dhebbeker/robot-control/robot-control-src/src/device_drivers/README.md

\dir .
\brief device drivers

This directory contains device drivers.
The drivers are not specific for a certain application or hardware.
They each support a specific device which may be configured.
