dhebbeker/robot-control/doc/follow-wall-angle/WinkelberechnungV4-2.pdf

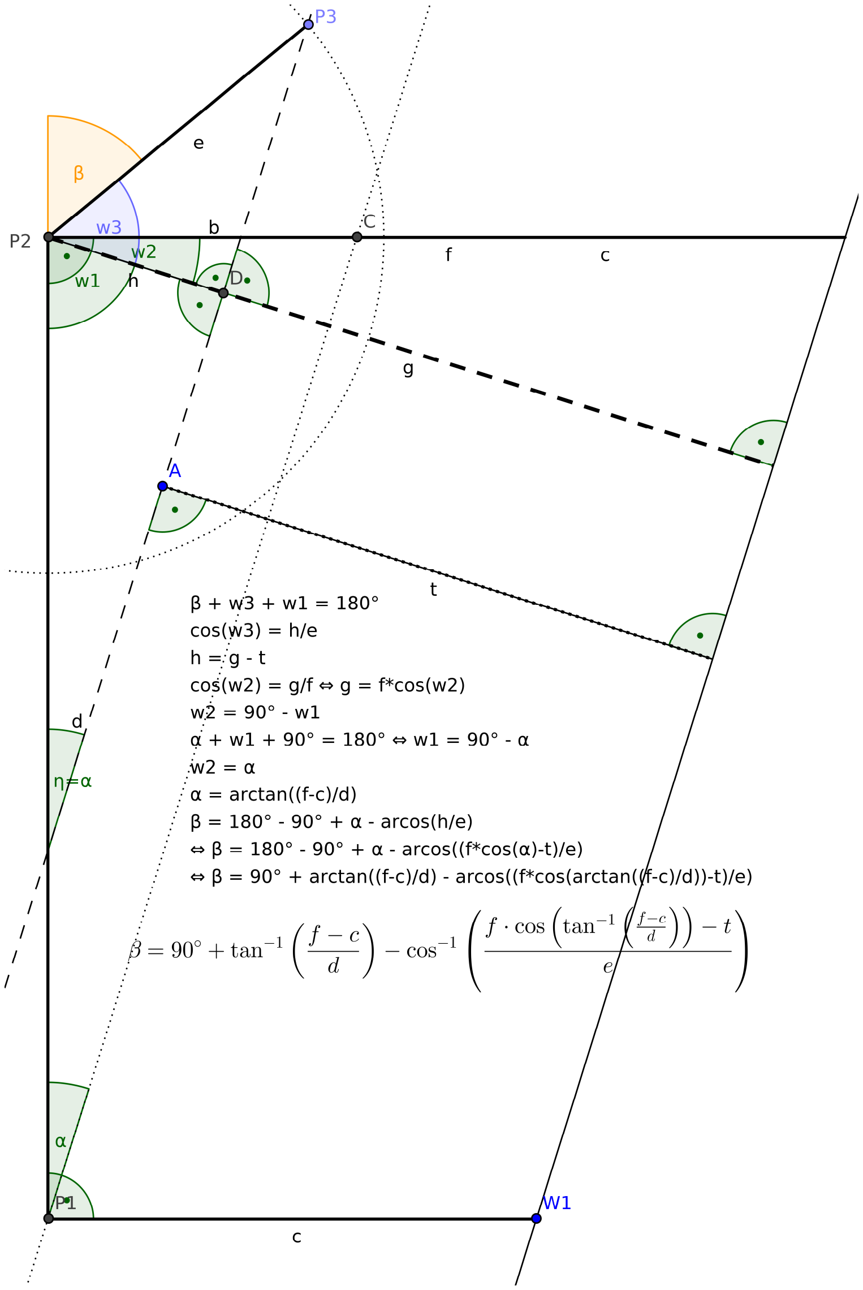
[picture p3: page 1]
