dhebbeker/robot-control/doc/follow-wall-angle/WinkelberechnungV4.pdf

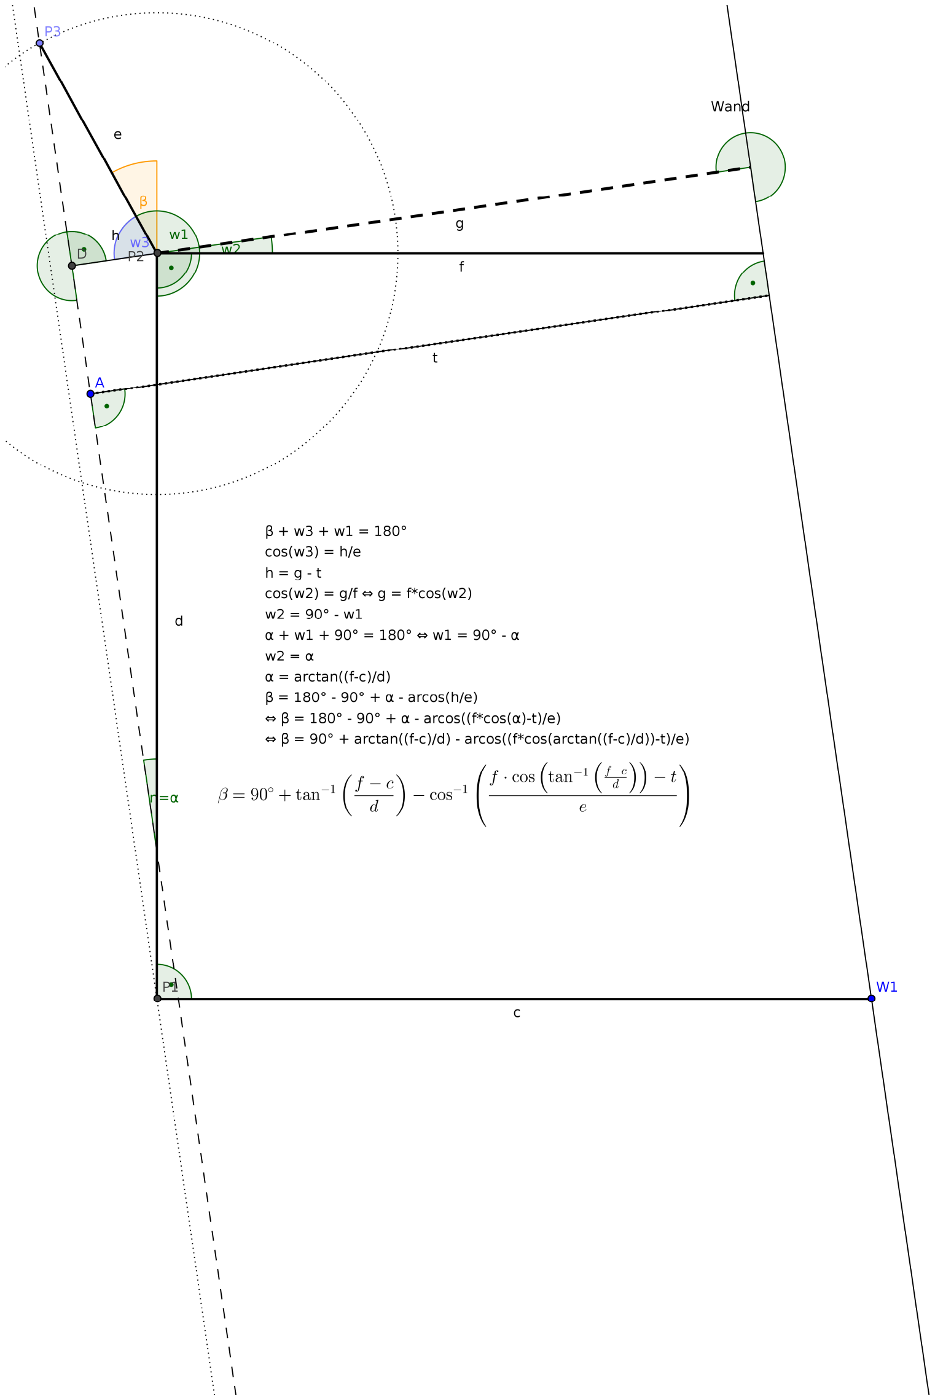
[picture p4: page 1]
