dhebbeker/robot-control/hardware/robot-control-circuit/robot-control-circuit.kicad_pcb

## KiCad design hardware/robot-control-circuit/robot-control-circuit.kicad_pcb (2021-12-05)

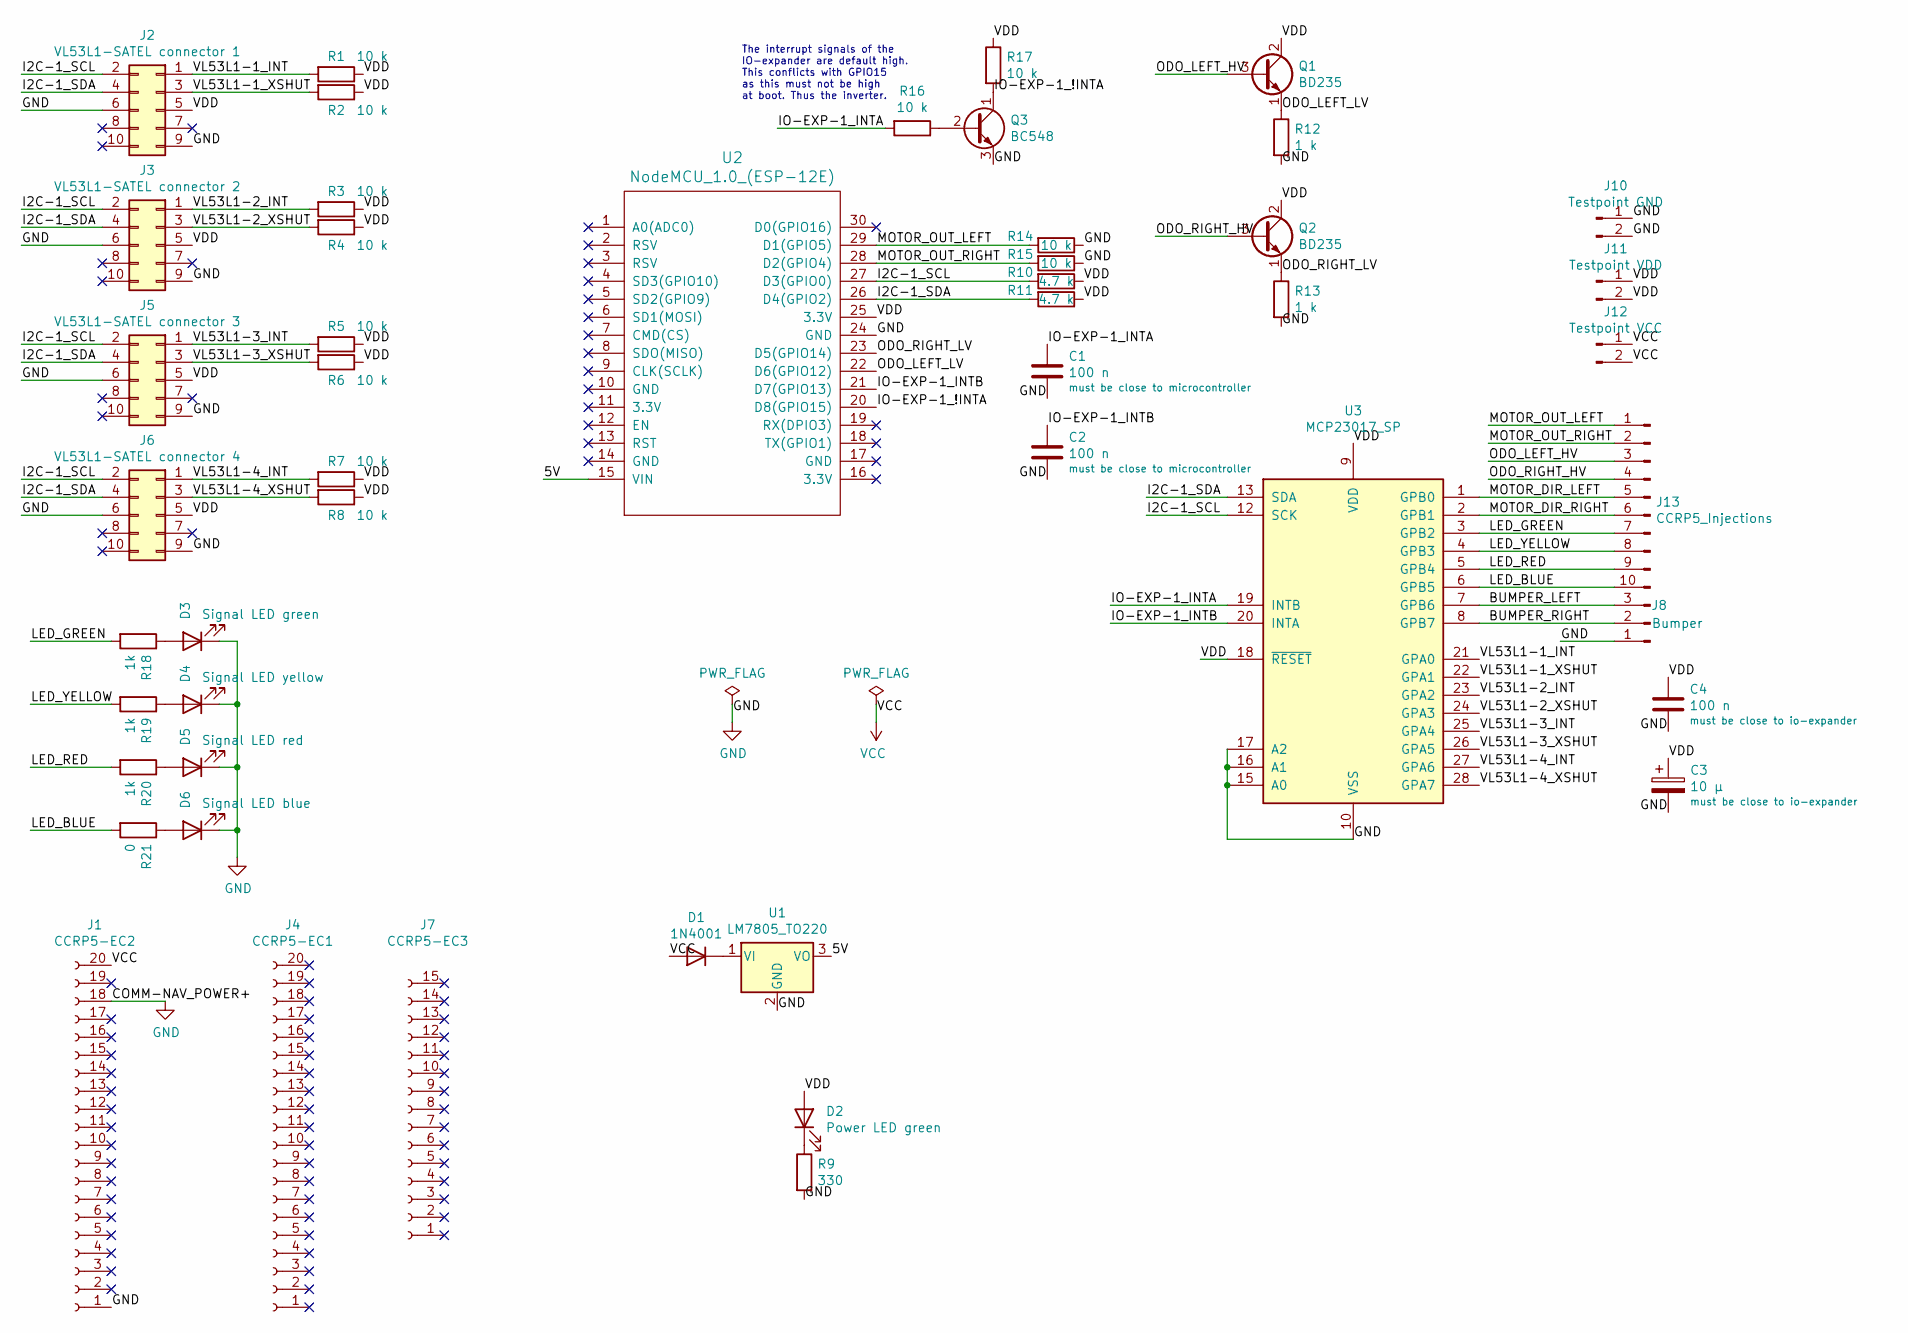
[picture p5: schematic robot-control-circuit.sch, Navigation Board]

Parts:
C1, C2, C4: 100 n; C_Rect_L4.6mm_W2.0mm_P2.50mm_MKS02_FKP02
C3: 10 µ; CP_Radial_D5.0mm_P2.50mm
D1: 1N4001; D_DO-34_SOD68_P2.54mm_Vertical_KathodeUp
D2: Power LED green; LED_D3.0mm
D3: Signal LED green; LED_D3.0mm
D4: Signal LED yellow; LED_D3.0mm
D5: Signal LED red; LED_D3.0mm
D6: Signal LED blue; LED_D3.0mm
J1: CCRP5-EC2; PinHeader_1x20_P2.54mm_Vertical; Part SSA-120-W-T
J2: VL53L1-SATEL connector 1; PinSocket_2x05_P2.54mm_Horizontal
J3: VL53L1-SATEL connector 2; PinSocket_2x05_P2.54mm_Horizontal
J4: CCRP5-EC1; PinHeader_1x20_P2.54mm_Vertical; Part SSA-120-W-T
J5: VL53L1-SATEL connector 3; PinSocket_2x05_P2.54mm_Horizontal
J6: VL53L1-SATEL connector 4; PinSocket_2x05_P2.54mm_Horizontal
J7: CCRP5-EC3; PinHeader_1x15_P2.54mm_Vertical
J8: Bumper; PinHeader_1x03_P2.54mm_Vertical
J10: Testpoint GND; PinHeader_1x02_P2.54mm_Vertical
J11: Testpoint VDD; PinHeader_1x02_P2.54mm_Vertical
J12: Testpoint VCC; PinHeader_1x02_P2.54mm_Vertical
J13: CCRP5_Injections; PinHeader_1x10_P2.54mm_Vertical
Q1, Q2: BD235; TO-126-3_Vertical
Q3: BC548; TO-92_Inline_Wide
R1, R2, R3, R4, R5, R6, R7, R8, R14, R15, R16, R17: 10 k; R_Axial_DIN0204_L3.6mm_D1.6mm_P2.54mm_Vertical
R9: 330; R_Axial_DIN0204_L3.6mm_D1.6mm_P2.54mm_Vertical
R10, R11: 4.7 k; R_Axial_DIN0204_L3.6mm_D1.6mm_P2.54mm_Vertical
R12, R13: 1 k; R_Axial_DIN0204_L3.6mm_D1.6mm_P2.54mm_Vertical
R18, R19, R20: 1k; R_Axial_DIN0204_L3.6mm_D1.6mm_P2.54mm_Vertical
R21: 0; R_Axial_DIN0204_L3.6mm_D1.6mm_P2.54mm_Vertical
U1: LM7805_TO220; TO-220-3_Vertical
U2: NodeMCU_1.0_(ESP-12E); NodeMCU1.0(12-E)
U3: MCP23017_SP; DIP-28_W7.62mm

Connections:
/5V: U1.3 (VO), U2.15 (VIN)
/BUMPER_LEFT: J8.3, U3.7 (GPB6)
/BUMPER_RIGHT: J8.2, U3.8 (GPB7)
/I2C-1_SCL: J2.2, J3.2, J5.2, J6.2, R10.2, U2.27 (D3(GPIO0)), U3.12 (SCK)
/I2C-1_SDA: J2.4, J3.4, J5.4, J6.4, R11.2, U2.26 (D4(GPIO2)), U3.13 (SDA)
/IO-EXP-1_!INTA: Q3.1 (C), R17.2, U2.20 (D8(GPIO15))
/IO-EXP-1_INTA: C1.1, R16.2, U3.19 (INTB)
/IO-EXP-1_INTB: C2.1, U2.21 (D7(GPIO13)), U3.20 (INTA)
/LED_BLUE: J13.10, R21.2, U3.6 (GPB5)
/LED_GREEN: J13.7, R18.2, U3.3 (GPB2)
/LED_RED: J13.9, R20.2, U3.5 (GPB4)
/LED_YELLOW: J13.8, R19.2, U3.4 (GPB3)
/MOTOR_DIR_LEFT: J13.5, U3.1 (GPB0)
/MOTOR_DIR_RIGHT: J13.6, U3.2 (GPB1)
/MOTOR_OUT_LEFT: J13.1, R14.2, U2.29 (D1(GPIO5))
/MOTOR_OUT_RIGHT: J13.2, R15.2, U2.28 (D2(GPIO4))
/ODO_LEFT_HV: J13.3, Q1.3 (B)
/ODO_LEFT_LV: Q1.1 (E), R12.1, U2.22 (D6(GPIO12))
/ODO_RIGHT_HV: J13.4, Q2.3 (B)
/ODO_RIGHT_LV: Q2.1 (E), R13.1, U2.23 (D5(GPIO14))
/VDD: C3.1, C4.1, D2.2 (A), J2.5, J3.5, J5.5, J6.5, J11.1, J11.2, Q1.2 (C), Q2.2 (C), R1.1, R2.1, R3.1, R4.1, R5.1, R6.1, R7.1, R8.1, R10.1, R11.1, R17.1, U2.25 (3.3V), U3.9 (VDD), U3.18 (~RESET~)
/VL53L1-1_INT: J2.1, R1.2, U3.21 (GPA0)
/VL53L1-1_XSHUT: J2.3, R2.2, U3.22 (GPA1)
/VL53L1-2_INT: J3.1, R3.2, U3.23 (GPA2)
/VL53L1-2_XSHUT: J3.3, R4.2, U3.24 (GPA3)
/VL53L1-3_INT: J5.1, R5.2, U3.25 (GPA4)
/VL53L1-3_XSHUT: J5.3, R6.2, U3.26 (GPA5)
/VL53L1-4_INT: J6.1, R7.2, U3.27 (GPA6)
/VL53L1-4_XSHUT: J6.3, R8.2, U3.28 (GPA7)
GND: C1.2, C2.2, C3.2, C4.2, D3.1 (K), D4.1 (K), D5.1 (K), D6.1 (K), J1.1, J1.18, J2.6, J2.9, J3.6, J3.9, J5.6, J5.9, J6.6, J6.9, J8.1, J10.1, J10.2, Q3.3 (E), R9.2, R12.2, R13.2, R14.1, R15.1, U1.2 (GND), U2.24 (GND), U3.10 (VSS), U3.15 (A0), U3.16 (A1), U3.17 (A2)
unnamed: D1.1 (K), U1.1 (VI)
unnamed: D2.1 (K), R9.1
unnamed: D3.2 (A), R18.1
unnamed: D4.2 (A), R19.1
unnamed: D5.2 (A), R20.1
unnamed: D6.2 (A), R21.1
unnamed: Q3.2 (B), R16.1
VCC: D1.2 (A), J1.20, J12.1, J12.2

Notes on the sheet:
The interrupt signals of the IO-expander are default high. This conflicts with GPIO15 as this must not be high at boot. Thus the inverter.

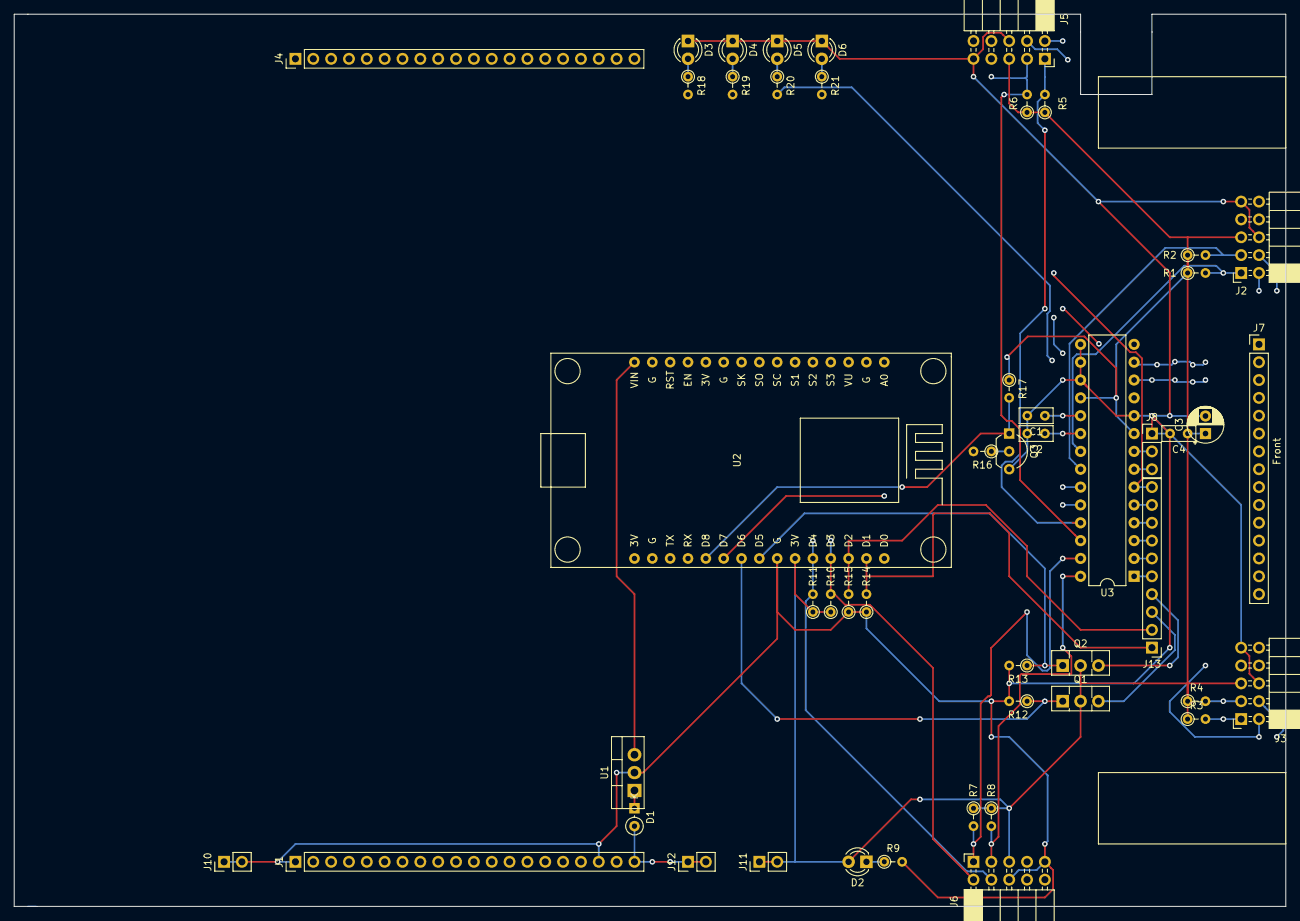
[picture p6: board robot-control-circuit.kicad_pcb from above]

Board: 4 copper layers, 181.0 x 127.0 mm, 49 parts (0 on the bottom side), 38 nets.
