dhebbeker/robot-control/(commit log)

2021-01-17 Add current work in progress.
    I have been working on this project for a couple of days since 2021-01-07.
2021-01-17 Added source code and documentation used to calibrate drives.
2021-04-25 Define circuit and PCB.
    Includes
    - 1 NodeMCU
    - 4 VL53C1CB breakout boards
    - 1 MCP23017 IO expander
    - 2 front bumper
    [robot-control-circuit.kicad_pcb, robot-control-circuit.sch]
2021-04-25 Add workaround for bug in external board package.
    See https://github.com/esp8266/Arduino/issues/5787#issuecomment-465852231
    Beware: The #undef directive must be issued after `#include <Arduino.h>` and before including any file that defines `std::round`.
    [Drives.hpp, board.hpp]
2021-05-01 Added inverter between D0 and !RESET of IO expander.
    As in case the IO expander is active during boot, it puts INTB high, which is connected to GPIO15 which shall not be high during boot. Else boot fails.
    [robot-control-circuit.kicad_pcb, robot-control-circuit.sch]
2021-05-02 Added capacitors for io-expander.
    [robot-control-circuit.kicad_pcb, robot-control-circuit.sch]
2021-05-02 Directly connect !RESET of IO-expander to VDD and invert INTA.
    [robot-control-circuit.kicad_pcb, robot-control-circuit.sch]
2021-05-04 Corrected left right bumper signal labels.
    [robot-control-circuit.sch]
2021-05-04 Add interface for GPIO and pin implementation.
2021-05-04 Change interface for virtual pin to integers.
    In order to be compatible with Arduino.
2021-05-04 Added function to attach interrupts to digital pin.
    Tested successfully!
2021-05-04 Add PWM function to DigitalPin.
2021-05-05 Added class for virtual pin on IO expander MCP23017.
2021-05-05 Add initialization of I2C for dedicated pins.
2021-05-05 Set correct I2C address for IO expander.
    [board.cpp]
2021-05-05 Initialize remaining board pins.
2021-05-06 Back to static Drive class template.
    Simplified ISR for odometry.
2021-05-09 Added documentation on odometry calculation.
    See https://rn-wissen.de/wiki/index.php/CCRP5#Odometrie
2021-05-09 Added threshold to odometry counter.
    In order to suppress bouncing.
2021-05-09 Attach bumper interrupt to stop condition.
2021-05-11 Fixed backward / forward direction.
    This is because the robot is now operated backwards by default.
    [Drives.cpp, Drives.hpp]
2021-05-11 Added lock to move but backwards in case bumper is pressed.
2021-05-19 Removed connection table from README.
    As that table is redundant to the schematics.
2021-05-19 Use public URI for kicad-ESP8266 submodule.
2021-05-23 Use VL53L1 sensors.
2021-10-10 Moved files to src/ directory for recursive build.
    See https://github.com/arduino/arduino-builder/pull/148
2021-10-10 Update doxygen configuration to version 1.9.3.
    - Automatic update with `doxygen -u`.
    - Added extension mapping for `ino` files (Arduino Sketches)
    - Added path for mainpage
2021-10-23 Added prototype for circular buffer.
2021-10-24 Change sensor report to single range.
2021-10-24 Change sensor report to store sensor distance.
2021-10-24 Add function to steer drives with independent speed.
2021-10-24 Rotate in case no wall is seen.
2021-10-29 Update ESP8266 board support package.
2021-10-29 Renamed template parameter as the compiler did not like it.
    ¯\_(ツ)_/¯
2021-10-30 Instruct the user to use ESP8266 board support package version 2.7.4 (downgrade).
    Because of issue with compiler.
    See
    - https://github.com/espressif/esp-idf/issues/4542
    - https://gcc.gnu.org/bugzilla/show_bug.cgi?id=70435
2021-10-30 Add safety not to attempt to turn for 0 steps.
    As this may still lead to turning because the stop is only triggered after the sensor is triggered.
2021-10-30 Fix error in calculation of angle.
    [main.cpp]
2021-11-01 Fix problem with negative rotation.
    [Drives.cpp]
2021-11-01 Add wait in order to give the sensor some slack.
    If the robot is in constant motion this may make the measurement difficult.
2021-11-06 Move isBumperPressed() to board.
2021-11-06 Begin to write a state machine for bearing functionality.
2021-11-06 Add missing namespace prefix.
    [main.cpp]
2021-11-06 Move Distance to board.
2021-11-06 Fix non-static constexpr member.
    [Bearing.cpp]
2021-11-06 Refactoring board.
    Hide pins and other hardware as good as possible within the scope of board.
2021-11-07 Add calibration function.
2021-11-07 Add calibrated values.
2021-11-07 Move workaround for Arduino defined macros to header.
    [Drives.cpp]
2021-11-07 Fix calculation of vector to blip.
    [Bearing.cpp, Bearing.hpp]
2021-11-08 Added LEDs for generic signaling purposes.
    [robot-control-circuit.kicad_pcb, robot-control-circuit.sch]
2021-11-17 Connected new LEDs.
    [robot-control-circuit.kicad_pcb, robot-control-circuit.sch]
2021-11-28 Added documentation to state machine Bearing operation() member functions.
2021-12-05 Added debug LEDs.
2021-12-05 Change white debug led.
2021-12-05 Add initial test for distance sensors.
2022-01-06 Apply PollingStateMachine to Bearing class.
2022-01-08 Add function to retrieve a specific sensor or an error.
    [board.cpp, board.hpp]
2022-01-08 Declare lost in case no wall can be found on the right side.
2022-01-09 Use automatic calculation of sensor numbers.
2022-01-09 Reduce the number of used distance sensor structures.
2022-02-04 Update STM32duino_VL53L1 library to 2.1.0.
2022-02-19 Replace call to non-constexpr function by constexpr literal.
    The previous code was non-standard conform.
    [FollowingWallStates.cpp]
2022-02-27 Replace ° by degrees.
    As symbol is not properly shown on serial terminal.
    [Bearing.cpp, Bearing.hpp]
2022-03-13 Make test for distance sensores available to main().
2022-05-07 Drives: Only evaluate intervall in case the drive is not supposed to be idle.
2022-05-07 Correct format of printf of unsigned long.
    [Drives.cpp]
2022-05-07 Rework drives calibration function.
    [Drives.cpp]
2022-05-07 Calibrate rotation.
2022-05-08 Changed sensor from front-right to front-left.
2022-05-08 Add yield() in order to avoid "Soft WDT reset".
    [FollowingWallStates.cpp]
2022-05-12 Manage includes, include guards and use explicit.
    Use explicit in order to avoid unintentional conversions.
    [Bearing.cpp, Bearing.hpp, Drives.hpp, board.cpp, board.hpp, main.cpp]
2022-05-12 Re-added webserver.
    This reverts commit 8979a3042e51abb840871faab4e669606a54a4cd.
    [main.cpp]
2022-05-15 Added helper function for constexpr max().
    This is necessary as:
    - C++11 is used and there max() is not declared constexpr
    - C++11 is used because the compiler version supporting C++14 has a bug (see https://github.com/espressif/esp-idf/issues/4542)
    - function must be declared in a namespace, as Arduino.h declares std::max in global namespace 😠 https://github.com/esp8266/Arduino/commit/dfcaa1b85464f16156d0920dd6ddff5697ac13dc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
    - code copied from https://en.cppreference.com/w/cpp/algorithm/max#Possible_implementation
2022-05-15 Added button on website to control function "follow wall".
2022-05-15 Add possibilities to start and stop bearing activity.
2022-05-19 Round distances to multiples of the odometry intervall.
    Because else, the algorithm assumes that distances are driven which can actually not be achieved.
2022-06-01 Avoid that the dividend is greater than the divisor.
    As this results to an invalid argument to acos().
    [FollowingWallStates.cpp]
2022-06-11 Use for distance sensor a structure composed of the sensor interface and the angle the sensor directs to.
2022-07-25 Describe issue with coarse odometry sensor.
